korken89/ssla/ssla.kicad_pcb

## KiCad design ssla.kicad_pcb (2024-11-13)

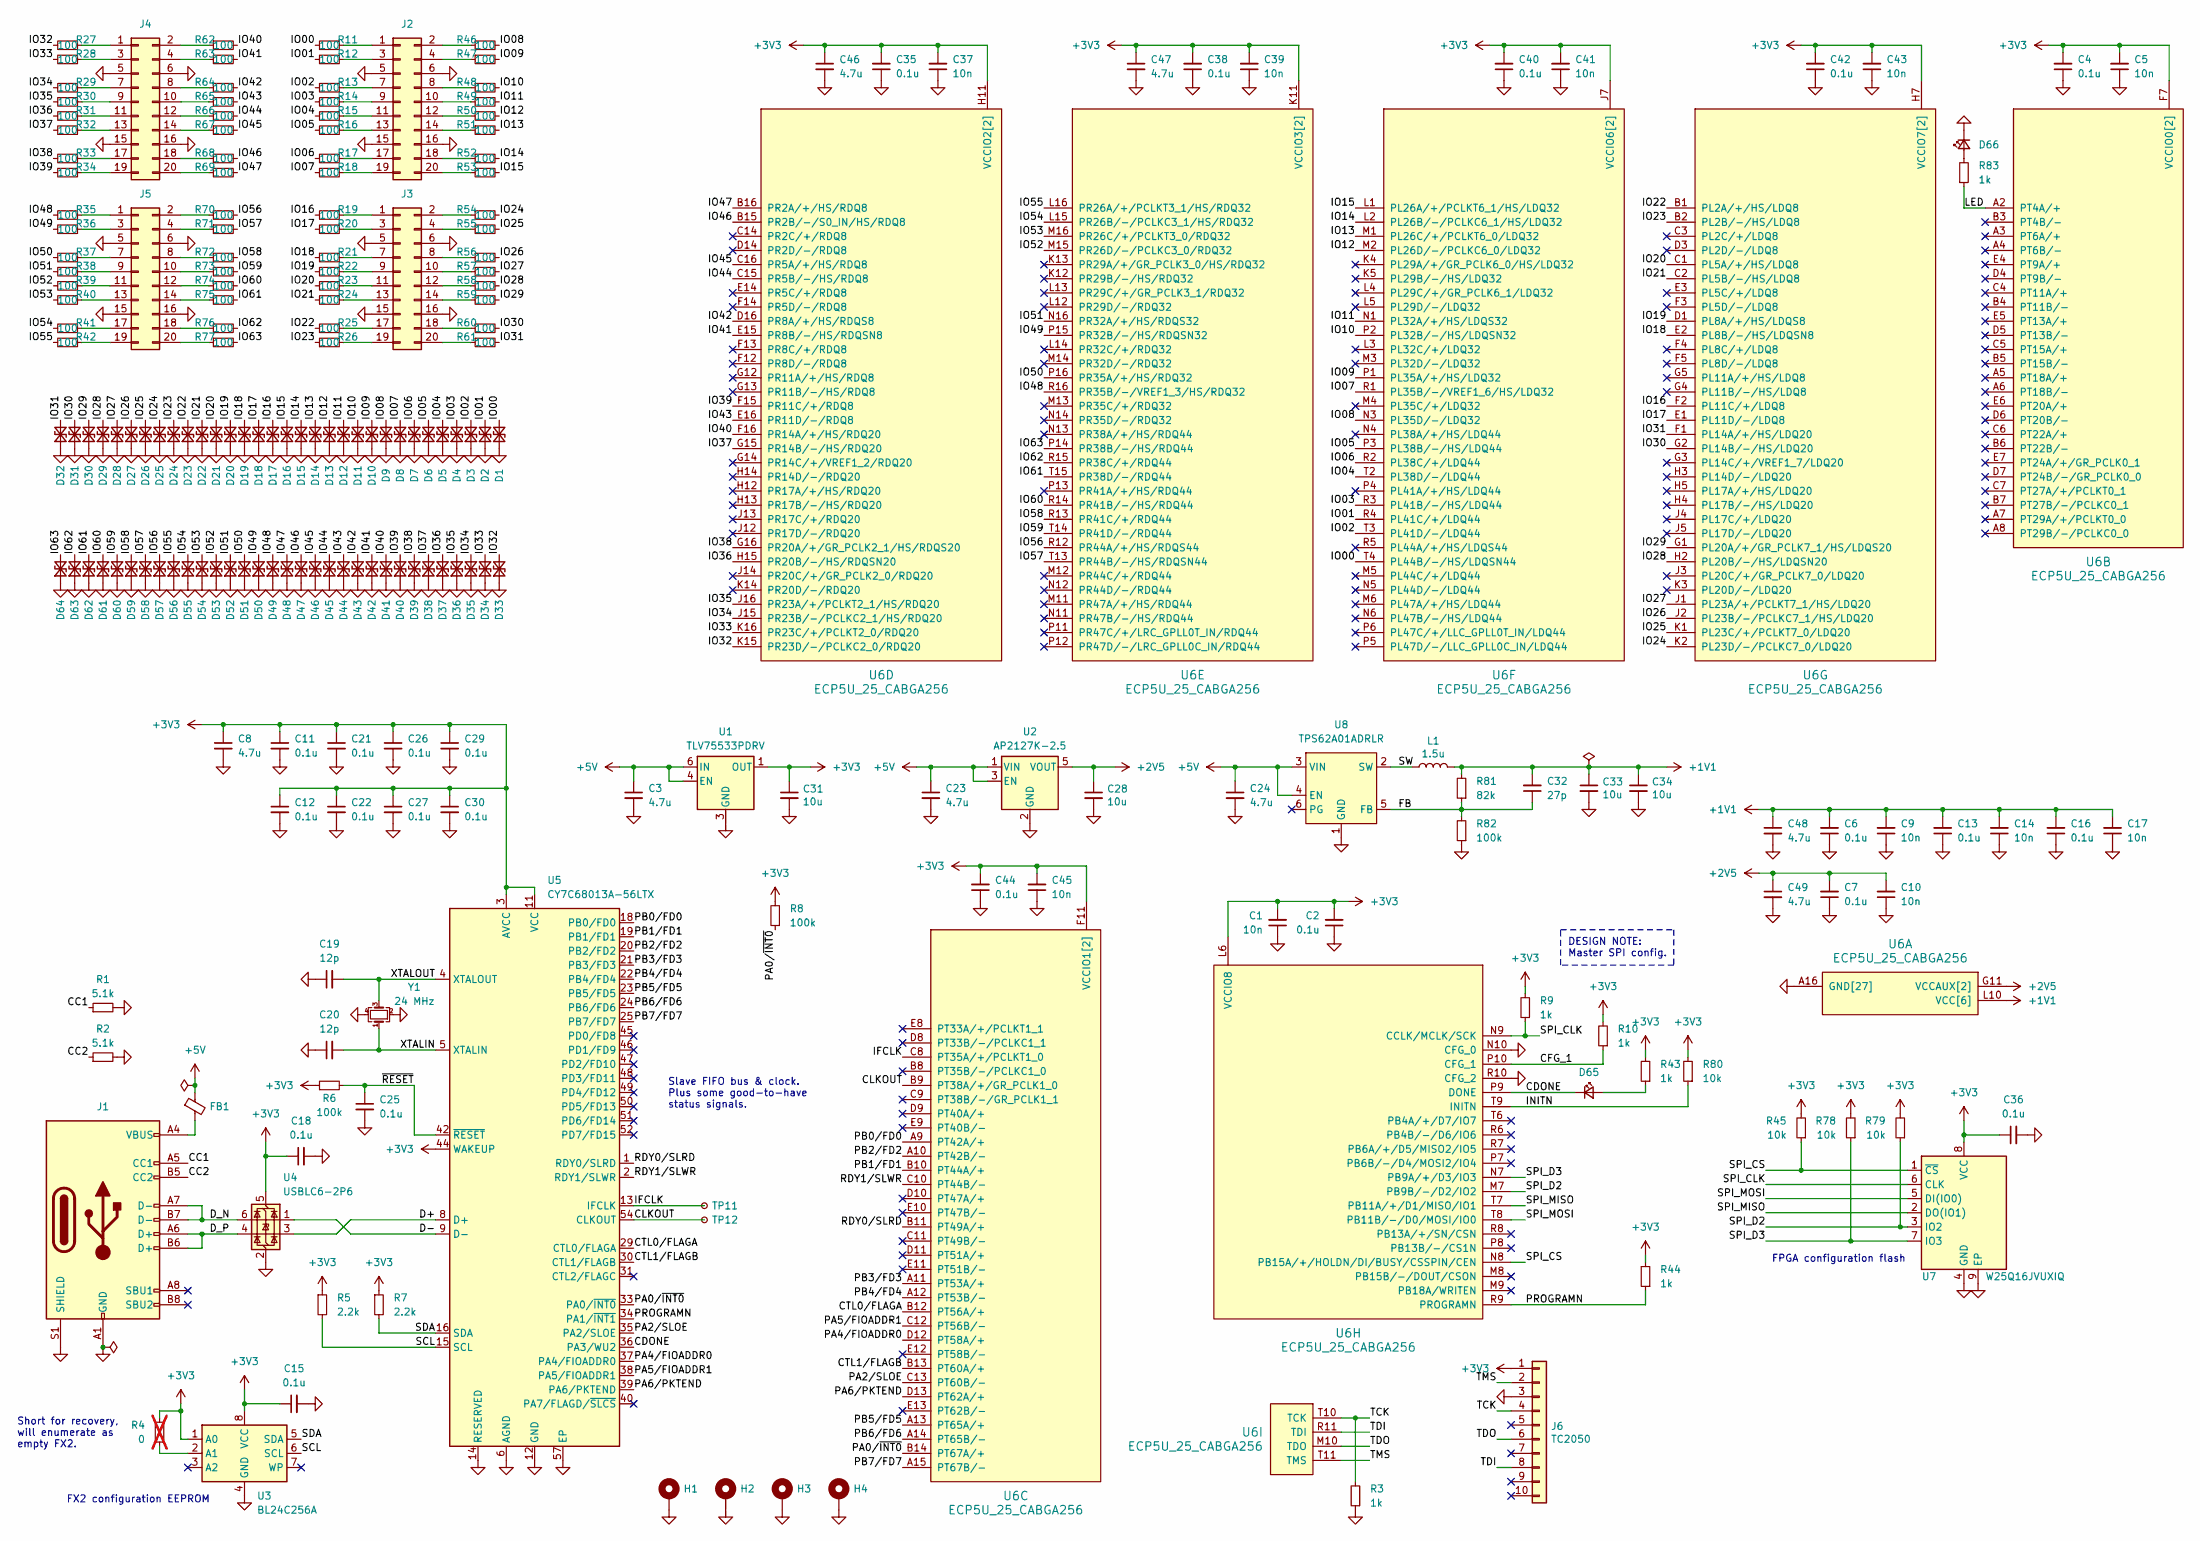
[picture p1: schematic ssla.kicad_sch]

Parts:
C1, C5, C9, C10, C14, C17, C37, C39, C41, C43, C45: 10n; C_0402_1005Metric; LCSC C15195
C2, C4, C6, C7, C11, C12, C13, C15, C16, C18, C21, C22, C25, C26, C27, C29, C30, C35, C36, C38, C40, C42, C44: 0.1u; C_0402_1005Metric; LCSC C307331
C3, C8, C23, C24, C46, C47, C48, C49: 4.7u; C_0402_1005Metric; LCSC C23733
C19, C20: 12p; C_0402_1005Metric; LCSC C1547
C28, C31, C33, C34: 10u; C_0603_1608Metric; LCSC C182375
C32: 27p; C_0402_1005Metric; LCSC C126504
D1, D2, D3, D4, D5, D6, D7, D8, D9, D10, D11, D12, D13, D14, D15, D16, D17, D18, D19, D20, D21, D22, D23, D24, D25, D26, D27, D28, D29, D30, D31, D32, D33, D34, D35, D36, D37, D38, D39, D40, D41, D42, D43, D44, D45, D46, D47, D48, D49, D50, D51, D52, D53, D54, D55, D56, D57, D58, D59, D60, D61, D62, D63, D64: D_TVS_Small; D_SOD-923; LCSC C96512
D65, D66: LED_Small; LED_0603_1608Metric
FB1: FerriteBead_Small; R_0402_1005Metric; LCSC C491490
H1, H2, H3, H4: MountingHole_Pad; MountingHole_2.2mm_M2_Pad_Via
J1: USB_C_Receptacle_USB2.0_14P; USB_C_Receptacle_GCT_USB4105-xx-A_16P_TopMnt_Horizontal; LCSC C165948
J2, J3, J4, J5: Conn_02x10_Odd_Even; IDC-Header_2x10_P2.54mm_Vertical; LCSC C221051
J6: TC2050; Tag-Connect_TC2050-IDC-NL_2x05_P1.27mm_Vertical
L1: 1.5u; L_1008_2520Metric; LCSC C2047523
R1, R2: 5.1k; R_0402_1005Metric; LCSC C25905
R3, R9, R10, R43, R44, R83: 1k; R_0402_1005Metric; LCSC C11702
R4: 0; R_0805_2012Metric; not fitted
R5, R7: 2.2k; R_0402_1005Metric; LCSC C25933
R6, R8, R82: 100k; R_0402_1005Metric; LCSC C258090
R11, R12, R13, R14, R15, R16, R17, R18, R19, R20, R21, R22, R23, R24, R25, R26, R27, R28, R29, R30, R31, R32, R33, R34, R35, R36, R37, R38, R39, R40, R41, R42, R46, R47, R48, R49, R50, R51, R52, R53, R54, R55, R56, R57, R58, R59, R60, R61, R62, R63, R64, R65, R66, R67, R68, R69, R70, R71, R72, R73, R74, R75, R76, R77: 100; R_0402_1005Metric; LCSC C25076
R45, R78, R79, R80: 10k; R_0402_1005Metric; LCSC C25744
R81: 82k; R_0402_1005Metric; LCSC C4142
TP11, TP12: TestPoint_Small; TestPoint_Pad_D1.0mm
U1: TLV75533PDRV; WSON-6-1EP_2x2mm_P0.65mm_EP1x1.6mm; LCSC C2861750
U2: AP2127K-2.5; SOT-23-5; LCSC C460326
U3: BL24C256A; TSSOP-8_4.4x3mm_P0.65mm; LCSC C110276
U4: USBLC6-2P6; SOT-666; LCSC C15999
U5: CY7C68013A-56LTX; QFN-56-1EP_8x8mm_P0.5mm_EP4.5x5.2mm; LCSC C14912
U6: ECP5U_25_CABGA256; BGA-256_14.0x14.0mm_Layout16x16_P0.8mm_Ball0.45mm_Pad0.32mm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
U7: W25Q16JVUXIQ; Winbond_USON-8-1EP_3x2mm_P0.5mm_EP0.2x1.6mm; LCSC C2843335
U8: TPS62A01ADRLR; SOT-563; LCSC C5181455
Y1: 24 MHz; Crystal_SMD_2016-4Pin_2.0x1.6mm; LCSC C2689430

Connections:
+1V1: C6.2, C9.2, C13.2, C14.2, C16.2, C17.2, C32.2, C33.1, C34.1, C48.1, L1.2, R81.2, U6.G6 (VCC[6]), U6.G7 (VCC[6]), U6.G9 (VCC[6]), U6.L8 (VCC[6]), U6.L9 (VCC[6]), U6.L10 (VCC[6])
+2V5: C7.2, C10.2, C28.1, C49.1, U2.5 (VOUT), U6.G11 (VCCAUX[2]), U6.L7 (VCCAUX[2])
+3V3: C1.2, C2.2, C4.2, C5.2, C8.1, C11.1, C12.1, C15.1, C18.1, C21.1, C22.1, C26.1, C27.1, C29.1, C30.1, C31.1, C35.2, C36.1, C37.2, C38.2, C39.2, C40.2, C41.2, C42.2, C43.2, C44.2, C45.2, C46.1, C47.1, J6.1, R4.1, R5.1, R6.1, R7.1, R8.2, R9.2, R10.2, R43.2, R44.2, R45.2, R78.2, R79.2, R80.2, U1.1 (OUT), U3.1 (A0), U3.8 (VCC), U4.5 (VBUS), U5.3 (AVCC), U5.7 (AVCC), U5.11 (VCC), U5.17 (VCC), U5.27 (VCC), U5.32 (VCC), U5.43 (VCC), U5.44 (WAKEUP), U5.55 (VCC), U6.F6 (VCCIO0[2]), U6.F7 (VCCIO0[2]), U6.F10 (VCCIO1[2]), U6.F11 (VCCIO1[2]), U6.H6 (VCCIO7[2]), U6.H7 (VCCIO7[2]), U6.H11 (VCCIO2[2]), U6.J6 (VCCIO6[2]), U6.J7 (VCCIO6[2]), U6.J11 (VCCIO2[2]), U6.K11 (VCCIO3[2]), U6.L6 (VCCIO8), U6.L11 (VCCIO3[2]), U7.8 (VCC)
+5V: C3.1, C23.1, C24.1, FB1.1, U1.4 (EN), U1.6 (IN), U2.1 (VIN), U2.3 (EN), U8.3 (VIN), U8.4 (EN)
/CC1: J1.A5 (CC1), R1.1
/CC2: J1.B5 (CC2), R2.1
/CDONE: D65.1 (K), U5.36 (PA3/WU2), U6.P9 (DONE)
/CFG_1: R10.1, U6.P10 (CFG_1)
/CLKOUT: TP12.1, U5.54 (CLKOUT), U6.B9 (PT38A/+/GR_PCLK1_0)
/CTL0/FLAGA: U5.29 (CTL0/FLAGA), U6.B12 (PT56A/+)
/CTL1/FLAGB: U5.30 (CTL1/FLAGB), U6.B13 (PT60A/+)
/D+: U4.3 (I/O2), U5.8 (D+)
/D-: U4.1 (I/O1), U5.9 (D-)
/D_N: J1.A7 (D-), J1.B7 (D-), U4.6 (I/O1)
/D_P: J1.A6 (D+), J1.B6 (D+), U4.4 (I/O2)
/FB: C32.1, R81.1, R82.2, U8.5 (FB)
/IFCLK: TP11.1, U5.13 (IFCLK), U6.C8 (PT35A/+/PCLKT1_0)
/INITN: R80.1, U6.T9 (INITN)
/IO00: D1.2 (A2), R11.2, U6.T4 (PL44B/-/HS/LDQSN44)
/IO01: D2.2 (A2), R12.2, U6.R4 (PL41C/+/LDQ44)
/IO02: D3.2 (A2), R13.2, U6.T3 (PL41D/-/LDQ44)
/IO03: D4.2 (A2), R14.2, U6.R3 (PL41B/-/HS/LDQ44)
/IO04: D5.2 (A2), R15.2, U6.T2 (PL38D/-/LDQ44)
/IO05: D6.2 (A2), R16.2, U6.P3 (PL38B/-/HS/LDQ44)
/IO06: D7.2 (A2), R17.2, U6.R2 (PL38C/+/LDQ44)
/IO07: D8.2 (A2), R18.2, U6.R1 (PL35B/-/VREF1_6/HS/LDQ32)
/IO08: D9.2 (A2), R46.2, U6.N3 (PL35D/-/LDQ32)
/IO09: D10.2 (A2), R47.2, U6.P1 (PL35A/+/HS/LDQ32)
/IO10: D11.2 (A2), R48.2, U6.P2 (PL32B/-/HS/LDQSN32)
/IO11: D12.2 (A2), R49.2, U6.N1 (PL32A/+/HS/LDQS32)
/IO12: D13.2 (A2), R50.2, U6.M2 (PL26D/-/PCLKC6_0/LDQ32)
/IO13: D14.2 (A2), R51.2, U6.M1 (PL26C/+/PCLKT6_0/LDQ32)
/IO14: D15.2 (A2), R52.2, U6.L2 (PL26B/-/PCLKC6_1/HS/LDQ32)
/IO15: D16.2 (A2), R53.2, U6.L1 (PL26A/+/PCLKT6_1/HS/LDQ32)
/IO16: D17.2 (A2), R19.2, U6.F2 (PL11C/+/LDQ8)
/IO17: D18.2 (A2), R20.2, U6.E1 (PL11D/-/LDQ8)
/IO18: D19.2 (A2), R21.2, U6.E2 (PL8B/-/HS/LDQSN8)
/IO19: D20.2 (A2), R22.2, U6.D1 (PL8A/+/HS/LDQS8)
/IO20: D21.2 (A2), R23.2, U6.C1 (PL5A/+/HS/LDQ8)
/IO21: D22.2 (A2), R24.2, U6.C2 (PL5B/-/HS/LDQ8)
/IO22: D23.2 (A2), R25.2, U6.B1 (PL2A/+/HS/LDQ8)
/IO23: D24.2 (A2), R26.2, U6.B2 (PL2B/-/HS/LDQ8)
/IO24: D25.2 (A2), R54.2, U6.K2 (PL23D/-/PCLKC7_0/LDQ20)
/IO25: D26.2 (A2), R55.2, U6.K1 (PL23C/+/PCLKT7_0/LDQ20)
/IO26: D27.2 (A2), R56.2, U6.J2 (PL23B/-/PCLKC7_1/HS/LDQ20)
/IO27: D28.2 (A2), R57.2, U6.J1 (PL23A/+/PCLKT7_1/HS/LDQ20)
/IO28: D29.2 (A2), R58.2, U6.H2 (PL20B/-/HS/LDQSN20)
/IO29: D30.2 (A2), R59.2, U6.G1 (PL20A/+/GR_PCLK7_1/HS/LDQS20)
/IO30: D31.2 (A2), R60.2, U6.G2 (PL14B/-/HS/LDQ20)
/IO31: D32.2 (A2), R61.2, U6.F1 (PL14A/+/HS/LDQ20)
/IO32: D33.2 (A2), R27.2, U6.K15 (PR23D/-/PCLKC2_0/RDQ20)
/IO33: D34.2 (A2), R28.2, U6.K16 (PR23C/+/PCLKT2_0/RDQ20)
/IO34: D35.2 (A2), R29.2, U6.J15 (PR23B/-/PCLKC2_1/HS/RDQ20)
/IO35: D36.2 (A2), R30.2, U6.J16 (PR23A/+/PCLKT2_1/HS/RDQ20)
/IO36: D37.2 (A2), R31.2, U6.H15 (PR20B/-/HS/RDQSN20)
/IO37: D38.2 (A2), R32.2, U6.G15 (PR14B/-/HS/RDQ20)
/IO38: D39.2 (A2), R33.2, U6.G16 (PR20A/+/GR_PCLK2_1/HS/RDQS20)
/IO39: D40.2 (A2), R34.2, U6.F15 (PR11C/+/RDQ8)
/IO40: D41.2 (A2), R62.2, U6.F16 (PR14A/+/HS/RDQ20)
/IO41: D42.2 (A2), R63.2, U6.E15 (PR8B/-/HS/RDQSN8)
/IO42: D43.2 (A2), R64.2, U6.D16 (PR8A/+/HS/RDQS8)
/IO43: D44.2 (A2), R65.2, U6.E16 (PR11D/-/RDQ8)
/IO44: D45.2 (A2), R66.2, U6.C15 (PR5B/-/HS/RDQ8)
/IO45: D46.2 (A2), R67.2, U6.C16 (PR5A/+/HS/RDQ8)
/IO46: D47.2 (A2), R68.2, U6.B15 (PR2B/-/S0_IN/HS/RDQ8)
/IO47: D48.2 (A2), R69.2, U6.B16 (PR2A/+/HS/RDQ8)
/IO48: D49.2 (A2), R35.2, U6.R16 (PR35B/-/VREF1_3/HS/RDQ32)
/IO49: D50.2 (A2), R36.2, U6.P15 (PR32B/-/HS/RDQSN32)
/IO50: D51.2 (A2), R37.2, U6.P16 (PR35A/+/HS/RDQ32)
/IO51: D52.2 (A2), R38.2, U6.N16 (PR32A/+/HS/RDQS32)
/IO52: D53.2 (A2), R39.2, U6.M15 (PR26D/-/PCLKC3_0/RDQ32)
/IO53: D54.2 (A2), R40.2, U6.M16 (PR26C/+/PCLKT3_0/RDQ32)
/IO54: D55.2 (A2), R41.2, U6.L15 (PR26B/-/PCLKC3_1/HS/RDQ32)
/IO55: D56.2 (A2), R42.2, U6.L16 (PR26A/+/PCLKT3_1/HS/RDQ32)
/IO56: D57.2 (A2), R70.2, U6.R12 (PR44A/+/HS/RDQS44)
/IO57: D58.2 (A2), R71.2, U6.T13 (PR44B/-/HS/RDQSN44)
/IO58: D59.2 (A2), R72.2, U6.R13 (PR41C/+/RDQ44)
/IO59: D60.2 (A2), R73.2, U6.T14 (PR41D/-/RDQ44)
/IO60: D61.2 (A2), R74.2, U6.R14 (PR41B/-/HS/RDQ44)
/IO61: D62.2 (A2), R75.2, U6.T15 (PR38D/-/RDQ44)
/IO62: D63.2 (A2), R76.2, U6.R15 (PR38C/+/RDQ44)
/IO63: D64.2 (A2), R77.2, U6.P14 (PR38B/-/HS/RDQ44)
/LED: R83.1, U6.A2 (PT4A/+)
/PA0/~INT0: R8.1, U5.33 (PA0/~INT0), U6.B14 (PT67A/+)
/PA2/SLOE: U5.35 (PA2/SLOE), U6.C13 (PT60B/-)
/PA4/FIOADDR0: U5.37 (PA4/FIOADDR0), U6.D12 (PT58A/+)
/PA5/FIOADDR1: U5.38 (PA5/FIOADDR1), U6.C12 (PT56B/-)
/PA6/PKTEND: U5.39 (PA6/PKTEND), U6.D13 (PT62A/+)
/PB0/FD0: U5.18 (PB0/FD0), U6.A9 (PT42A/+)
/PB1/FD1: U5.19 (PB1/FD1), U6.B10 (PT44A/+)
/PB2/FD2: U5.20 (PB2/FD2), U6.A10 (PT42B/-)
/PB3/FD3: U5.21 (PB3/FD3), U6.A11 (PT53A/+)
/PB4/FD4: U5.22 (PB4/FD4), U6.A12 (PT53B/-)
/PB5/FD5: U5.23 (PB5/FD5), U6.A13 (PT65A/+)
/PB6/FD6: U5.24 (PB6/FD6), U6.A14 (PT65B/-)
/PB7/FD7: U5.25 (PB7/FD7), U6.A15 (PT67B/-)
/PROGRAMN: R44.1, U5.34 (PA1/~INT1), U6.R9 (PROGRAMN)
/RDY0/SLRD: U5.1 (RDY0/SLRD), U6.B11 (PT49A/+)
/RDY1/SLWR: U5.2 (RDY1/SLWR), U6.C10 (PT44B/-)
/SCL: R5.2, U3.6 (SCL), U5.15 (SCL)
/SDA: R7.2, U3.5 (SDA), U5.16 (SDA)
/SPI_CLK: R9.1, U6.N9 (CCLK/MCLK/SCK), U7.6 (CLK)
/SPI_CS: R45.1, U6.N8 (PB15A/+/HOLDN/DI/BUSY/CSSPIN/CEN), U7.1 (~CS)
/SPI_D2: R79.1, U6.M7 (PB9B/-/D2/IO2), U7.3 (IO2)
/SPI_D3: R78.1, U6.N7 (PB9A/+/D3/IO3), U7.7 (IO3)
/SPI_MISO: U6.T7 (PB11A/+/D1/MISO/IO1), U7.2 (DO(IO1))
/SPI_MOSI: U6.T8 (PB11B/-/D0/MOSI/IO0), U7.5 (DI(IO0))
/SW: L1.1, U8.2 (SW)
/TCK: J6.4, R3.2, U6.T10 (TCK)
/TDI: J6.8, U6.R11 (TDI)
/TDO: J6.6, U6.M10 (TDO)
/TMS: J6.2, U6.T11 (TMS)
/XTALIN: C20.2, U5.5 (XTALIN), Y1.1
/XTALOUT: C19.2, U5.4 (XTALOUT), Y1.3
/~RESET: C25.1, R6.2, U5.42 (~RESET)
GND: C1.1, C2.1, C3.2, C4.1, C5.1, C6.1, C7.1, C8.2, C9.1, C10.1, C11.2, C12.2, C13.1, C14.1, C15.2, C16.1, C17.1, C18.2, C19.1, C20.1, C21.2, C22.2, C23.2, C24.2, C25.2, C26.2, C27.2, C28.2, C29.2, C30.2, C31.2, C33.2, C34.2, C35.1, C36.2, C37.1, C38.1, C39.1, C40.1, C41.1, C42.1, C43.1, C44.1, C45.1, C46.2, C47.2, C48.2, C49.2, D1.1 (A1), D2.1 (A1), D3.1 (A1), D4.1 (A1), D5.1 (A1), D6.1 (A1), D7.1 (A1), D8.1 (A1), D9.1 (A1), D10.1 (A1), D11.1 (A1), D12.1 (A1), D13.1 (A1), D14.1 (A1), D15.1 (A1), D16.1 (A1), D17.1 (A1), D18.1 (A1), D19.1 (A1), D20.1 (A1), D21.1 (A1), D22.1 (A1), D23.1 (A1), D24.1 (A1), D25.1 (A1), D26.1 (A1), D27.1 (A1), D28.1 (A1), D29.1 (A1), D30.1 (A1), D31.1 (A1), D32.1 (A1), D33.1 (A1), D34.1 (A1), D35.1 (A1), D36.1 (A1), D37.1 (A1), D38.1 (A1), D39.1 (A1), D40.1 (A1), D41.1 (A1), D42.1 (A1), D43.1 (A1), D44.1 (A1), D45.1 (A1), D46.1 (A1), D47.1 (A1), D48.1 (A1), D49.1 (A1), D50.1 (A1), D51.1 (A1), D52.1 (A1), D53.1 (A1), D54.1 (A1), D55.1 (A1), D56.1 (A1), D57.1 (A1), D58.1 (A1), D59.1 (A1), D60.1 (A1), D61.1 (A1), D62.1 (A1), D63.1 (A1), D64.1 (A1), D66.1 (K), H1.1, H2.1, H3.1, H4.1, J1.A1 (GND), J1.A12 (GND), J1.B1 (GND), J1.B12 (GND), J1.S1 (SHIELD), J2.5, J2.6, J2.15, J2.16, J3.5, J3.6, J3.15, J3.16, J4.5, J4.6, J4.15, J4.16, J5.5, J5.6, J5.15, J5.16, J6.3, R1.2, R2.2, R3.1, R82.1, U1.3 (GND), U1.7 (GND), U2.2 (GND), U3.4 (GND), U4.2 (GND), U5.6 (AGND), U5.10 (AGND), U5.12 (GND), U5.14 (RESERVED), U5.26 (GND), U5.28 (GND), U5.41 (GND), U5.53 (GND), U5.56 (GND), U5.57 (EP), U6.A1 (GND[27]), U6.A16 (GND[27]), U6.D2 (GND[27]), U6.D15 (GND[27]), U6.F8 (GND[27]), U6.F9 (GND[27]), U6.G8 (GND[27]), U6.G10 (GND[27]), U6.H1 (GND[27]), U6.H8 (GND[27]), U6.H9 (GND[27]), U6.H10 (GND[27]), U6.H16 (GND[27]), U6.J8 (GND[27]), U6.J9 (GND[27]), U6.J10 (GND[27]), U6.K6 (GND[27]), U6.K7 (GND[27]), U6.K8 (GND[27]), U6.K9 (GND[27]), U6.K10 (GND[27]), U6.N2 (GND[27]), U6.N10 (CFG_0), U6.N15 (GND[27]), U6.R10 (CFG_2), U6.T1 (GND[27]), U6.T5 (GND[27]), U6.T12 (GND[27]), U6.T16 (GND[27]), U7.4 (GND), U7.9 (EP), U8.1 (GND), Y1.2, Y1.4
unnamed: D65.2 (A), R43.1
unnamed: D66.2 (A), R83.2
unnamed: FB1.2, J1.A4 (VBUS), J1.A9 (VBUS), J1.B4 (VBUS), J1.B9 (VBUS)
unnamed: J2.1, R11.1
unnamed: J2.2, R46.1
unnamed: J2.3, R12.1
unnamed: J2.4, R47.1
unnamed: J2.7, R13.1
unnamed: J2.8, R48.1
unnamed: J2.9, R14.1
unnamed: J2.10, R49.1
unnamed: J2.11, R15.1
unnamed: J2.12, R50.1
unnamed: J2.13, R16.1
unnamed: J2.14, R51.1
unnamed: J2.17, R17.1
unnamed: J2.18, R52.1
unnamed: J2.19, R18.1
unnamed: J2.20, R53.1
unnamed: J3.1, R19.1
unnamed: J3.2, R54.1
unnamed: J3.3, R20.1
unnamed: J3.4, R55.1
unnamed: J3.7, R21.1
unnamed: J3.8, R56.1
unnamed: J3.9, R22.1
unnamed: J3.10, R57.1
unnamed: J3.11, R23.1
unnamed: J3.12, R58.1
unnamed: J3.13, R24.1
unnamed: J3.14, R59.1
unnamed: J3.17, R25.1
unnamed: J3.18, R60.1
unnamed: J3.19, R26.1
unnamed: J3.20, R61.1
unnamed: J4.1, R27.1
unnamed: J4.2, R62.1
unnamed: J4.3, R28.1
unnamed: J4.4, R63.1
unnamed: J4.7, R29.1
unnamed: J4.8, R64.1
unnamed: J4.9, R30.1
unnamed: J4.10, R65.1
unnamed: J4.11, R31.1
unnamed: J4.12, R66.1
unnamed: J4.13, R32.1
unnamed: J4.14, R67.1
unnamed: J4.17, R33.1
unnamed: J4.18, R68.1
unnamed: J4.19, R34.1
unnamed: J4.20, R69.1
unnamed: J5.1, R35.1
unnamed: J5.2, R70.1
unnamed: J5.3, R36.1
unnamed: J5.4, R71.1
unnamed: J5.7, R37.1
unnamed: J5.8, R72.1
unnamed: J5.9, R38.1
unnamed: J5.10, R73.1
unnamed: J5.11, R39.1
unnamed: J5.12, R74.1
unnamed: J5.13, R40.1
unnamed: J5.14, R75.1
unnamed: J5.17, R41.1
unnamed: J5.18, R76.1
unnamed: J5.19, R42.1
unnamed: J5.20, R77.1
unnamed: R4.2, U3.2 (A1)

Notes on the sheet:
FX2 configuration EEPROM
FPGA configuration flash
Short for recovery, will enumerate as empty FX2.
Slave FIFO bus & clock. Plus some good-to-have status signals.
DESIGN NOTE: Master SPI config.

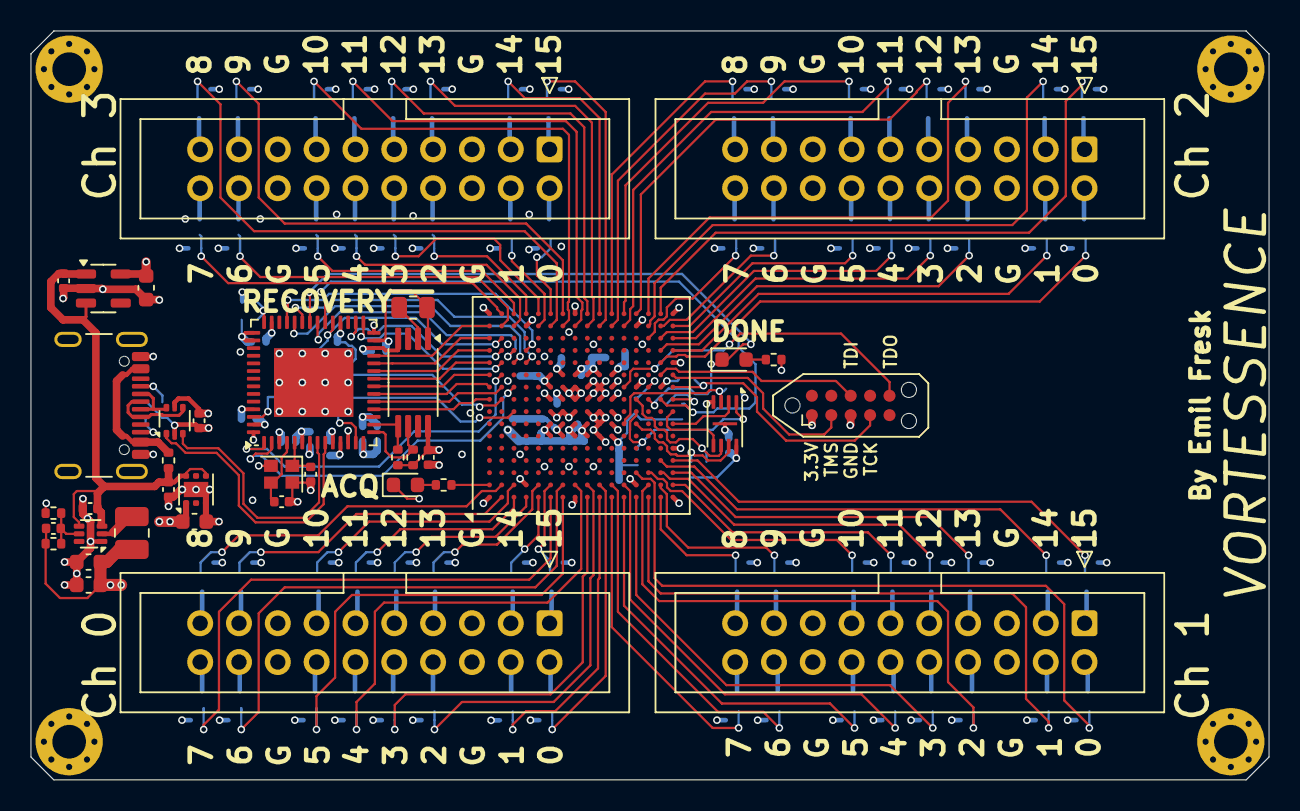
[picture p2: board ssla.kicad_pcb from above]

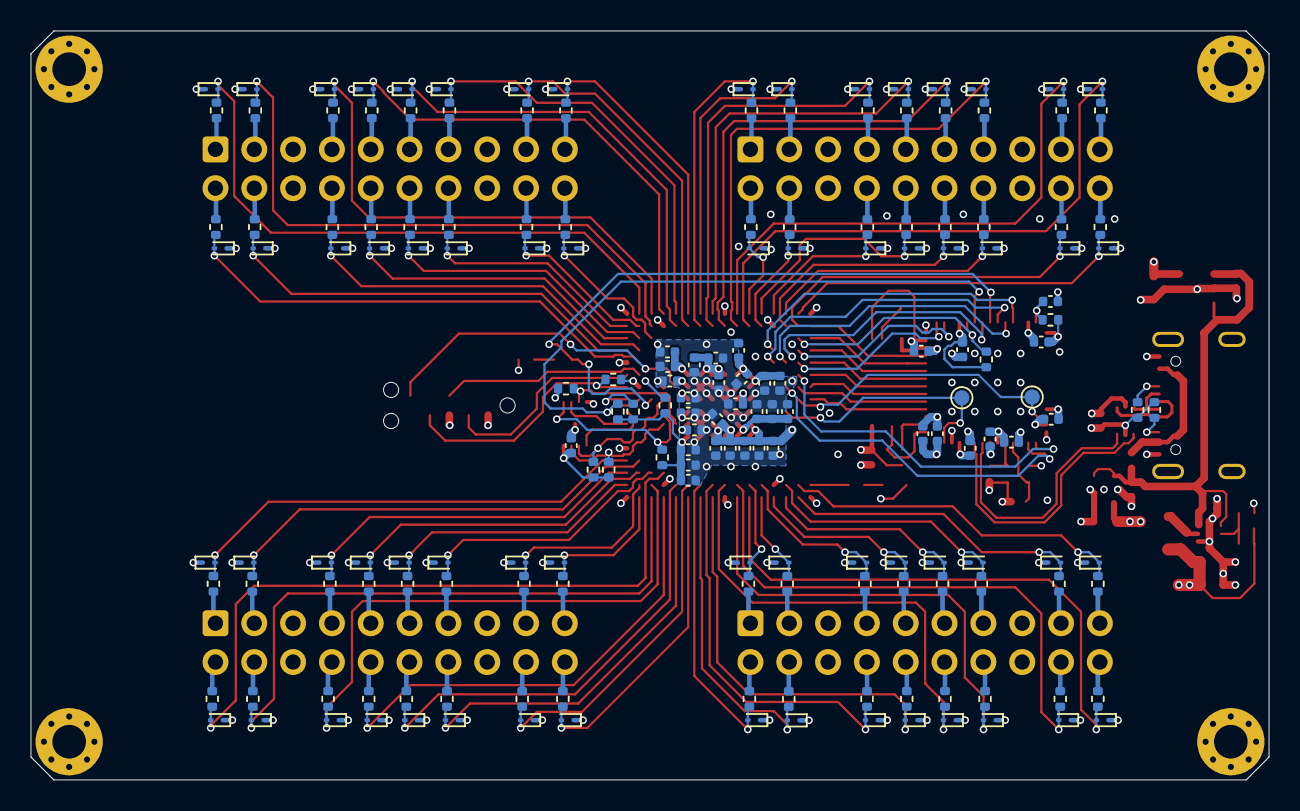
[picture p3: board ssla.kicad_pcb from below]

Board: 4 copper layers, 81.0 x 49.0 mm, 221 parts (179 on the bottom side), 184 nets.
