korken89/ssla/(commit log)

2024-11-10 0 unrouted
    [ssla.kicad_pcb, ssla.kicad_sch]
2024-11-11 LCSC part numbers, started moving to through-hole IDC connector
    [ssla.kicad_pcb, ssla.kicad_sch]
2024-11-12 Started move to ECP5
    [ssla.kicad_pcb, ssla.kicad_sch]
2024-11-19 Add script for printing all IO lines sorted by number
